apparentlymart/release-button/enclosure/parts.txt

Polycase WA-34 enclosure:
http://www.polycase.com/wa-34

Massive Arcade Button:
https://www.adafruit.com/products/1188

1.3" 128x64 monochrome OLED:
https://www.adafruit.com/products/938

Rotary Encoder:
https://www.adafruit.com/product/377

Rotary Encoder Knob:
http://www.ebay.com/itm/321575821589

Pi HAT id EEPROM:
http://www.digikey.com/product-detail/en/CAT24C32WI-G/CAT24C32WI-GOS-ND/2061011

Mini Speaker:
https://www.adafruit.com/product/1890

PAM8407DR stereo audio amplifier:
http://www.digikey.com/product-detail/en/PAM8407DR/PAM8407DRDICT-ND/4794811

Terminal blocks (for speakers):
https://www.adafruit.com/products/724
