apparentlymart/release-button/pcb/releasebuttonboard.kicad_pcb

## KiCad design pcb/releasebuttonboard.kicad_pcb (2015-01-05)

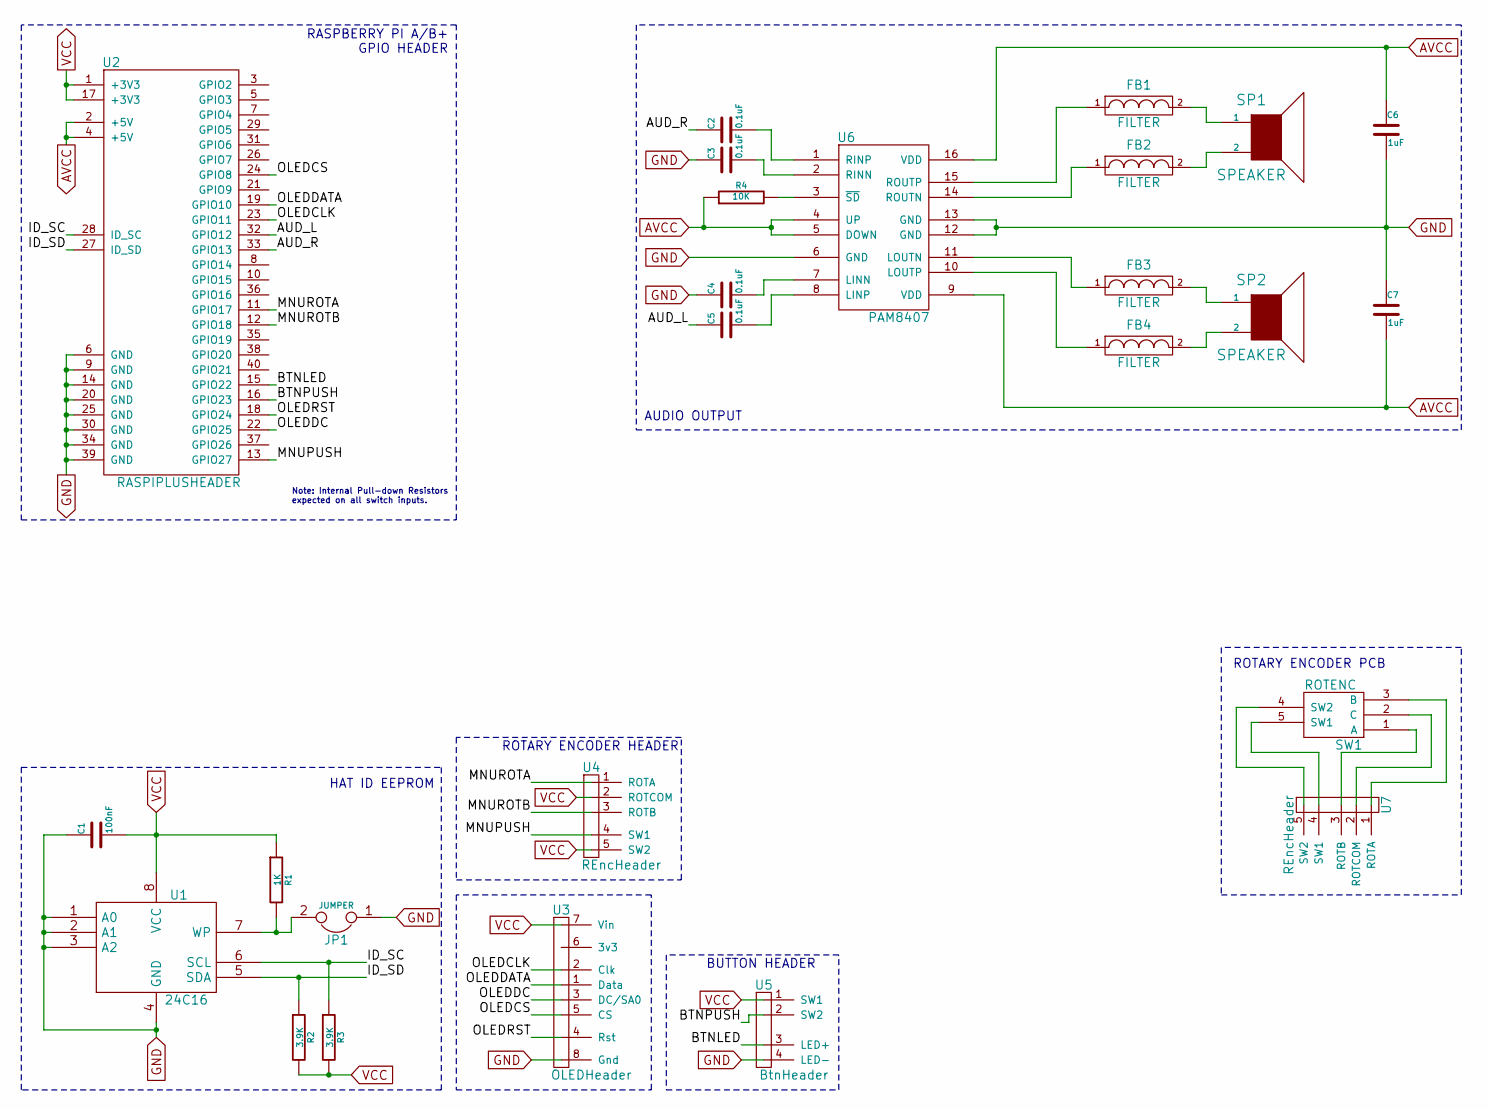
[picture p1: schematic releasebuttonboard.sch, Release Button PCB]

Parts:
C1: 100nF
C2, C3, C4, C5: 0.1uF
C6, C7: 1uF
FB1, FB2, FB3, FB4: FILTER
JP1: JUMPER
R1: 1K
R2, R3: 3.9K
R4: 10K
SP1, SP2: SPEAKER
SW1: ROTENC
U1: 24C16
U2: RASPIPLUSHEADER
U3: OLEDHeader
U4, U7: REncHeader
U5: BtnHeader
U6: PAM8407

Connections:
/AUD_L: C5.1, U2.32 (GPIO12)
/AUD_R: C2.1, U2.33 (GPIO13)
/BTNLED: U2.15 (GPIO22), U5.3 (LED+)
/BTNPUSH: U2.16 (GPIO23), U5.2 (SW2)
/ID_SC: R3.1, U1.6 (SCL), U2.28 (ID_SC)
/ID_SD: R2.1, U1.5 (SDA), U2.27 (ID_SD)
/MNUPUSH: U2.13 (GPIO27), U4.4 (SW1)
/MNUROTA: U2.11 (GPIO17), U4.1 (ROTA)
/MNUROTB: U2.12 (GPIO18), U4.3 (ROTB)
/OLEDCLK: U2.23 (GPIO11), U3.2 (Clk)
/OLEDCS: U2.24 (GPIO8), U3.5 (CS)
/OLEDDATA: U2.19 (GPIO10), U3.1 (Data)
/OLEDDC: U2.22 (GPIO25), U3.3 (DC/SA0)
/OLEDRST: U2.18 (GPIO24), U3.4 (Rst)
AVCC: C6.1, C7.2, R4.1, U2.2 (+5V), U2.4 (+5V), U6.4 (UP), U6.5 (DOWN), U6.9 (VDD), U6.16 (VDD)
GND: C1.1, C3.1, C4.1, C6.2, C7.1, JP1.1, U1.1 (A0), U1.2 (A1), U1.3 (A2), U1.4 (GND), U2.6 (GND), U2.9 (GND), U2.14 (GND), U2.20 (GND), U2.25 (GND), U2.30 (GND), U2.34 (GND), U2.39 (GND), U3.8 (Gnd), U5.4 (LED-), U6.6 (GND), U6.12 (GND), U6.13 (GND)
unnamed: C2.2, U6.1 (RINP)
unnamed: C3.2, U6.2 (RINN)
unnamed: C4.2, U6.7 (LINN)
unnamed: C5.2, U6.8 (LINP)
unnamed: FB1.1, U6.15 (ROUTP)
unnamed: FB1.2, SP1.1
unnamed: FB2.1, U6.14 (ROUTN)
unnamed: FB2.2, SP1.2
unnamed: FB3.1, U6.11 (LOUTN)
unnamed: FB3.2, SP2.1
unnamed: FB4.1, U6.10 (LOUTP)
unnamed: FB4.2, SP2.2
unnamed: JP1.2, R1.2, U1.7 (WP)
unnamed: R4.2, U6.3 (~SD)
unnamed: SW1.1 (A), U7.3 (ROTB)
unnamed: SW1.2 (C), U7.2 (ROTCOM)
unnamed: SW1.3 (B), U7.1 (ROTA)
unnamed: SW1.4 (SW2), U7.5 (SW2)
unnamed: SW1.5 (SW1), U7.4 (SW1)
VCC: C1.2, R1.1, R2.2, R3.2, U1.8 (VCC), U2.1 (+3V3), U2.17 (+3V3), U3.7 (Vin), U4.2 (ROTCOM), U4.5 (SW2), U5.1 (SW1)

Notes on the sheet:
HAT ID EEPROM
AUDIO OUTPUT
Note: Internal Pull-down Resistors expected on all switch inputs.
ROTARY ENCODER HEADER
BUTTON HEADER
RASPBERRY PI A/B+ GPIO HEADER
ROTARY ENCODER PCB

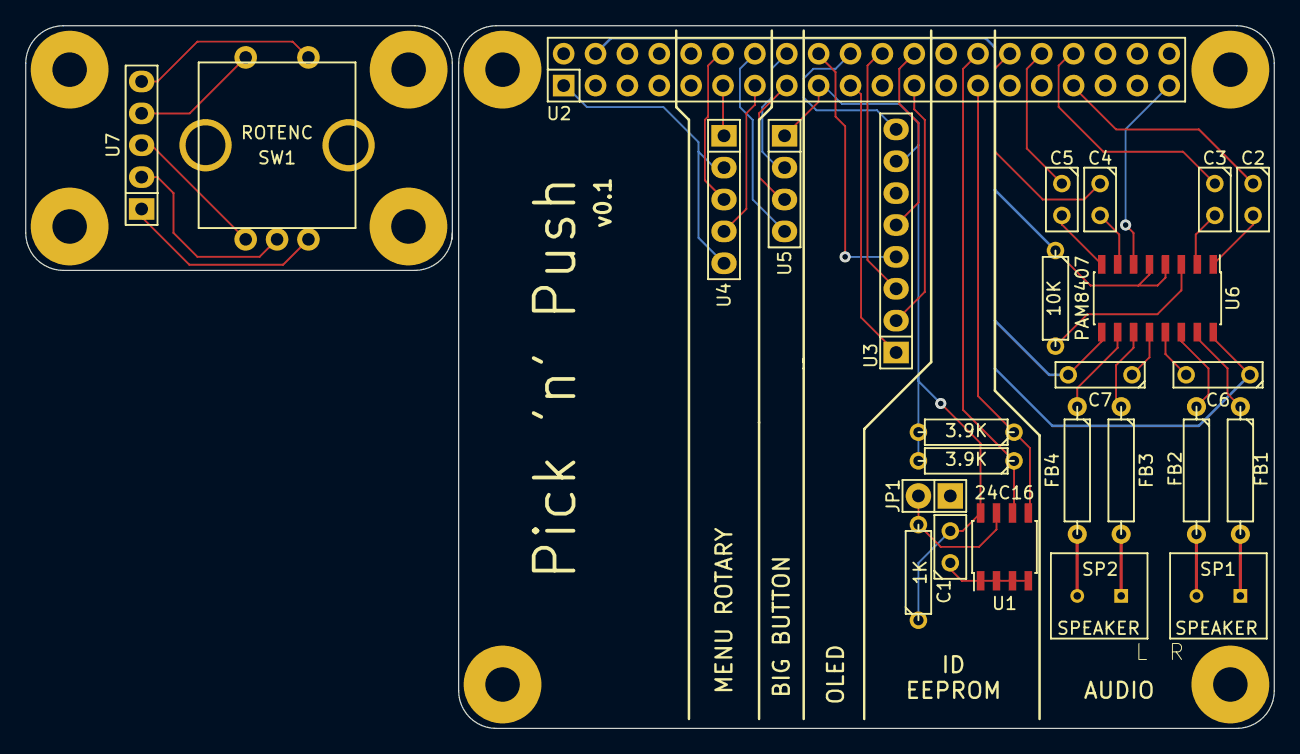
[picture p2: board releasebuttonboard.kicad_pcb from above]

Board: 4 copper layers, 65.0 x 56.0 mm, 34 parts (0 on the bottom side), 36 nets.

Other parts of the board:
Mounting_Hole_2.75mm, Mounting_Hole_2.75mm#2, Mounting_Hole_2.75mm#3, Mounting_Hole_2.75mm#4, Mounting_Hole_2.75mm#5, Mounting_Hole_2.75mm#6, Mounting_Hole_2.75mm#7, Mounting_Hole_2.75mm#8: VAL**; Mounting_Hole_2.75mm
