apparentlymart/release-button/(commit log)

2014-12-17 Basic infrastructure for rotary encoder.
2014-12-28 Quick, hacky experiment with rotary encoder.
    Reading a cheap rotary encoder successfully was a bit of an uphill battle
    but this program shows how it can be done in isolation. Something like
    this will eventually be incorporated into the main program.
2014-12-29 Start of modeling the enclosure with OpenSCAD.
    So far we have a model of the enclosure itself (which is a product from
    Polycase) and a model of what turned out to be the wrong size of button.
    There's also an overly-detailed STL model of the Raspberry Pi A+ in there
    which we'll probably later replace with a simpler model that's more
    amenable to CSG operations.
    [enclosure.scad]
2014-12-30 Model the lid of the enclosure along with the base.
    [enclosure.scad]
2014-12-30 Overview model with the button in place on the lid.
    [enclosure.scad]
2015-01-01 Center the model about the origin.
    Everything else is simpler this way.
    [enclosure.scad]
2015-01-01 Add the OLED and its breakout into the enclosure model.
    [enclosure.scad]
2015-01-01 Use a beveled edge around the display cutout.
    Not sure yet if Polycase can accommodate this with their CNC process so
    right now this is just aspirational and may get reverted if they can't
    support it.
    [enclosure.scad]
2015-01-01 Improve the accuracy of the OLED screen module.
    The physical dimensions are derived from the EagleCAD board file released
    by Adafruit, which gives enough information to model the physical outline
    somewhat accurately.
    The updated screen cutout rectangle is derived from the viewing window used
    in Adafruit's "Toaster Mac" 3D printer project.
    [enclosure.scad]
2015-01-01 Add tolerances to the cutouts.
    [enclosure.scad]
2015-01-01 Tiny adjustment to display cutout position.
    The display isn't quite centered on the module, but it's totally marginal
    and this difference is smaller than the cut tolerance, so this is really
    just for the sake of completeness.
    [enclosure.scad]
2015-01-01 Rotary encoder base.
    No knob or nut yet.
    [enclosure.scad]
2015-01-01 Add a hollow for the rotary encoder screw.
    The screw thread on the rotary encoder is too shallow to make it all the
    way through the top wall of the case, so this indent should allow it to
    screw down enough to stay fastened.
    [enclosure.scad]
2015-01-01 Add rotary encoder knob.
    [enclosure.scad]
2015-01-01 Add a straight lip on the screen cutout bevel.
    Cutting to a sharp edge is unlikely to work well, so we'll give a little
    bit of straight lip to avoid cutting the top wall too thin.
    [enclosure.scad]
2015-01-01 Add a bevel to the hollow for the rotary encoder.
    [enclosure.scad]
2015-01-03 KiCad project for PCB plus a library of schematics for the headers.
2015-01-03 Drop in the main components to the schematic.
    Not laid out or wired together yet.
    [releasebuttonboard.sch]
2015-01-03 Schematic of ID EEPROM subcircuit.
    (And some extra bits that crept in.)
    [releasebuttonboard.sch]
2015-01-03 Finish the ID EEPROM circuit.
    Previously we were missing the necessary IO pin pullups and a decoupling
    capacitor.
    [releasebuttonboard.sch]
2015-01-04 PAM8407 schematic symbol.
2015-01-04 Apparently KiCad wants component names in uppercase.
2015-01-04 Audio output circuit.
    [releasebuttonboard.sch]
2015-01-04 Connect OLED header to Raspberry Pi IO pins.
    [releasebuttonboard.sch]
2015-01-04 Rotary encoder header connections.
    [releasebuttonboard.sch]
2015-01-04 Header for big button.
    (Plus misc schematic layout changes.)
    [releasebuttonboard.sch]
2015-01-04 Component annotation.
    [releasebuttonboard.sch]
2015-01-04 Remove unused AVCC label.
    [releasebuttonboard.sch]
2015-01-04 Rotary encoder schematic symbol.
2015-01-04 Schematic for extra rotary encoder PCB.
    [releasebuttonboard.sch]
2015-01-04 More schematic annotation.
    [releasebuttonboard.sch]
2015-01-04 Fix rotary encoder header schematic reference.
    It seems that the case sensitivity rules change when moving between KiCad
    versions.
    [releasebuttonboard.sch]
2015-01-04 Custom PCB footprint library.
2015-01-04 Component to footprint mapping.
2015-01-04 PiHat PCB outline and mounting holes.
    [releasebuttonboard.kicad_pcb]
2015-01-04 Fix missing connection between ferrite and speaker terminal.
    [releasebuttonboard.sch]
2015-01-04 Initial component layout for the audio part of the PCB.
    [releasebuttonboard.kicad_pcb]
2015-01-04 Add separate ground pours for analog and digital.
    [releasebuttonboard.kicad_pcb]
2015-01-04 Route the analog part of the PCB.
    [releasebuttonboard.kicad_pcb]
2015-01-04 Starting to lay out the EEPROM curcuit and unamped audio.
    [releasebuttonboard.kicad_pcb]
2015-01-04 Further PCB traces and tweaks.
    [releasebuttonboard.kicad_pcb]
2015-01-04 Rearrange RaspPi pin assignments for more convenient routing.
    Some of the functions were too spread out on the physical header before.
    Now they are arranged into non-overlapping columns so the board can be
    more conveniently split into several distinct functions.
    [releasebuttonboard.sch]
2015-01-04 Update PCB for new netlist.
    [releasebuttonboard.kicad_pcb]
2015-01-04 Power the audio amp from the 5V supply.
    This should keep it a little more isolated from the digital supply as well
    as making it easier to route the power tracks.
    [releasebuttonboard.kicad_pcb, releasebuttonboard.sch]
2015-01-05 New vertical layout of the audio circuit.
    Easier to fit everything in this way and provide clear ground return paths,
    I hope. (Remains to be seen whether the traces will work out.)
    [releasebuttonboard.kicad_pcb]
2015-01-05 Track routing for the audio portion of the PCB.
    [releasebuttonboard.kicad_pcb]
2015-01-05 Add dummy copper layer to fake out signal connections on header pin.
    In order for the DRC to consider the routing to be complete it needs to
    know that the GND, VCC and AVCC pins (respectively) on the Raspberry Pi
    header will be connected by the Pi board itself and thus don't need to
    actually be connected on this board. We achieve this by providing a dummy
    copper layer that won't be included in the fab order.
    [releasebuttonboard.kicad_pcb]
2015-01-05 Use a bigger ground plane in the audio area.
    This expanded plane also includes the power supply tracks.
    [releasebuttonboard.kicad_pcb]
2015-01-05 Component placement for ID EEPROM region.
    [releasebuttonboard.kicad_pcb]
2015-01-05 Traces for ID EEPROM circuit portion.
    [releasebuttonboard.kicad_pcb]
2015-01-05 OLED header placement and routing.
    [releasebuttonboard.kicad_pcb]
2015-01-05 Connect the ID EEPROM data pins.
    [releasebuttonboard.kicad_pcb]
2015-01-05 Button and rotary encoder header placement and tracks.
    [releasebuttonboard.kicad_pcb]
2015-01-05 Place the board title text.
    [releasebuttonboard.kicad_pcb]
2015-01-05 Add a redundant track to help kicad see a connection.
    KiCad isn't seeing the connection between the via and the ground plane,
    so an extra copper trace line inside the ground plane completes the net.
    [releasebuttonboard.kicad_pcb]
2015-01-05 Tweak position of version number label.
    [releasebuttonboard.kicad_pcb]
2015-01-05 Separate rotary encoder PCB.
    [releasebuttonboard.kicad_pcb]
2015-01-05 Move AVCC trace away from the board edge.
    As it was, it risked being damaged by board outline cutting during
    manufacture.
    [releasebuttonboard.kicad_pcb]
